sufst/precharge/hardware/precharge/bom-2.ods

Part | MPN | FarnellPartNo | Datasheet | CostExVAT | PrechargeQty | TSALQty | HVSenseQty | MinQty | Total
DC-DC converter | MPWF1212S-3W | 3652712 | https://www.farnell.com/datasheets/3195172.pdf | £4.61 | 1 |  | 1 | 1 | £9.22
Power resistor | HSA50680RJ | 2058970 | https://www.farnell.com/datasheets/1498243.pdf | £4.07 | 1 |  |  | 1 | £4.07
Fuseholder clip | 8040.0001 | 1829517 | https://www.farnell.com/datasheets/2349362.pdf | £0.84 | 1 |  |  | 10 | £8.44
Fuse | 70-125-40/2A | 1175103 | https://www.farnell.com/datasheets/54183.pdf | £3.43 | 1 |  |  | 1 | £3.43
Optocoupler | 140817141410 | 3619675 | https://www.farnell.com/datasheets/3177005.pdf | £0.20 | 3 |  | 2 | 1 | £1.02
Small relays | G5Q-1EU DC12 | 4446434 | https://www.farnell.com/datasheets/2182433.pdf | £1.28 | 2 |  |  | 1 | £2.56
Updated small relay | PCH-112L2MH | 9659331 | https://www.farnell.com/datasheets/1922598.pdf | £1.52 | 2 |  |  | 1 | £3.04
10u | MCGPR50V106M5X11 | 9451382 | https://www.farnell.com/datasheets/2861351.pdf | £0.05 | 1 | 6 |  | 1 | £0.35
3.3u | MCGPR50V335M5X11 | 1902898 | https://www.farnell.com/datasheets/2861351.pdf | £0.05 | 1 |  |  | 1 | £0.05
4.7u | MCGPR50V475M5X11 | 9451374 | https://www.farnell.com/datasheets/2861351.pdf | £0.05 | 1 |  |  | 1 | £0.05
22u | MCGPR25V226M5X11 | 9451161 | https://www.farnell.com/datasheets/2861351.pdf | £0.05 | 1 |  | 1 | 1 | £0.10
100u | MCGPR25V107M6.3X11 | 9451188 | https://www.farnell.com/datasheets/2861351.pdf | £0.09 | 2 | 2 | 1 | 1 | £0.45
100n | MC0603B104K500CT | 1759122 | https://www.farnell.com/datasheets/2860632.pdf | £0.03 | 5 | 7 | 1 | 10 | £0.39
Diode | SS14+ | 2675133 | https://www.farnell.com/datasheets/2861407.pdf | £0.14 | 2 |  |  | 5 | £0.71
Diode | BAT54WFILM | 3214563 | https://www.farnell.com/datasheets/2124315.pdf | £0.22 | 8 | 5 | 1 | 5 | £3.02
Red LED | MP008277 | 3796306 | https://www.farnell.com/datasheets/3497874.pdf | £0.07 | 3 |  |  | 5 | £0.37
Green LED | MC011367 | 3015160 | https://www.farnell.com/datasheets/2864184.pdf | £0.03 | 5 |  | 1 | 5 | £0.16
NPN BJT | BC846A,215 | 1081228 |  | £0.11 | 1 |  |  | 5 | £0.54
PNP BJT | BC856A | 1798064 | https://www.farnell.com/datasheets/2915414.pdf | £0.09 | 3 |  |  | 5 | £0.43
Bigger MOSFETS | BUK7M9R5-40HX | 3020973 |  | £0.27 | 1 | 2 |  | 1 | £0.82
Small MOSFETs | XP262N7002TR-G | 3534793 | https://www.farnell.com/datasheets/3118352.pdf | £0.16 | 2 |  |  | 5 | £0.79
1k 0603 | MCWR06X1001FTL | 2447272 | https://www.farnell.com/datasheets/2860681.pdf | £0.00 | 6 |  |  | 10 | £0.04
1k 1206 | MCWR12X1001FTL | 2447473 |  | £0.01 | 3 |  | 2 | 10 | £0.12
10k | WF06P1002FTL | 2502802 | https://www.farnell.com/datasheets/1960323.pdf | £0.00 | 5 | 10 | 2 | 10 | £0.08
33k | ERA3VRB3302V | 3602666 | https://www.farnell.com/datasheets/3170174.pdf | £0.44 | 3 |  |  | 10 | £4.43
82k | WF06U8202BTL | 2502992 | https://www.farnell.com/datasheets/2341551.pdf | £0.06 | 1 |  |  | 10 | £0.62
1.5k | WF06U1501BTL | 2502942 | https://www.farnell.com/datasheets/2341550.pdf | £0.07 | 5 |  |  | 10 | £0.69
30k | CPF-A-0603B30KE1 | 2483916 | https://www.farnell.com/datasheets/1935020.pdf | £0.33 | 1 |  |  | 1 | £0.33
453k (0805) | MCWF08R4533BTL | 2337864 | https://www.farnell.com/datasheets/2860647.pdf | £0.16 | 24 |  | 6 | 10 | £4.92
560k (0805) | MCWF08R5603BTL | 2337914 | https://www.farnell.com/datasheets/2860647.pdf | £0.15 |  |  |  | 10 | £1.52
100k | WF06U1003BTL | 2502938 | https://www.farnell.com/datasheets/2341550.pdf | £0.07 | 4 | 1 |  | 10 | £0.68
5.1M | MC0063W060315M10 | 2141614 | https://www.farnell.com/datasheets/1788326.pdf | £0.00 | 1 |  |  | 1 | £0.00
470k | MCWR06X4703FTL | 2447373 | https://www.farnell.com/datasheets/2860681.pdf | £0.00 |  |  |  | 10 | £0.04
47k | CRG0603F47K | 3399581 | https://www.farnell.com/datasheets/2790373.pdf | £0.00 | 1 |  |  | 10 | £0.03
3.3k | CRG0603F3K3 | 3399579 | https://www.farnell.com/datasheets/2790373.pdf | £0.00 | 6 |  | 2 | 10 | £0.03
Thermistor | NCU18WF104J60RB | 3471633 | https://www.farnell.com/datasheets/3007002.pdf | £0.08 | 1 |  |  | 10 | £0.77
Op-amp | TLV274DR2G | 3588895 | https://www.onsemi.com/pub/Collateral/TLV271-D.PDF | £1.02 | 1 |  | 1 | 5 | £5.10
Hex Schmitt inverter | HCF40106YM013TR | 2762696 | https://www.farnell.com/datasheets/1790272.pdf | £0.54 | 1 | 3 |  | 5 | £2.70
Comparator | LM339DR2G | 1651910 | https://www.farnell.com/datasheets/2353742.pdf | £0.51 |  |  |  | 5 | £2.55
Flip-flop | CD4013BM96G4 | 3119949 |  | £0.55 | 1 | 1 |  | 1 | £1.10
OR gate | CD4071BM | 3006431 | https://www.farnell.com/datasheets/1878535.pdf | £0.50 | 1 | 1 |  | 1 | £1.00
105k | WF08U1053BTL | 2670115 |  | £0.09 | 1 |  |  | 10 | £0.93
31.6k | MCWF06R3162BTL | 2337131 |  | £0.11 | 1 |  |  | 10 | £1.06
348k | MCTC0525B3483T5G | 1576077 |  | £0.02 | 1 |  |  | 1 | £0.02
82r | MCSR06X82R0FTL | 2074314 |  | £0.01 | 1 |  |  | 10 | £0.09
150k | MCWF08U1503BTL | 2694207 |  | £0.17 | 1 |  |  | 10 | £1.67
Voltage reference | TL431ACDT | 2463970 |  | £0.36 | 1 |  |  | 5 | £1.79
Potentiometer | 3296W-1-504LF | 9353313 | https://www.farnell.com/datasheets/2061261.pdf | £2.19 | 1 |  |  | 1 | £2.19
Bright red LED | 150283RS73103 | 3408631 |  | £0.66 | 2 |  |  |  | £1.33
Bright green LED | 150283GS73103 | 3408634 |  | £0.71 | 2 |  |  |  | £1.41
82r 2512 | CRM2512-JW-820ELF | 2908507 |  | £0.19 | 8 |  |  | 10 | £1.93
27r 2512 | MCHP122WF270JT4E | 2426565 |  | £0.27 | 6 |  |  | 10 | £2.65
AND gate | CD4081BM96 | 3120149 |  | £0.57 | 2 |  |  | 5 | £2.84
 |  |  |  |  |  |  |  |  | £84.64
