sufst/precharge/hardware/precharge/step/pch-112l2mh.stp

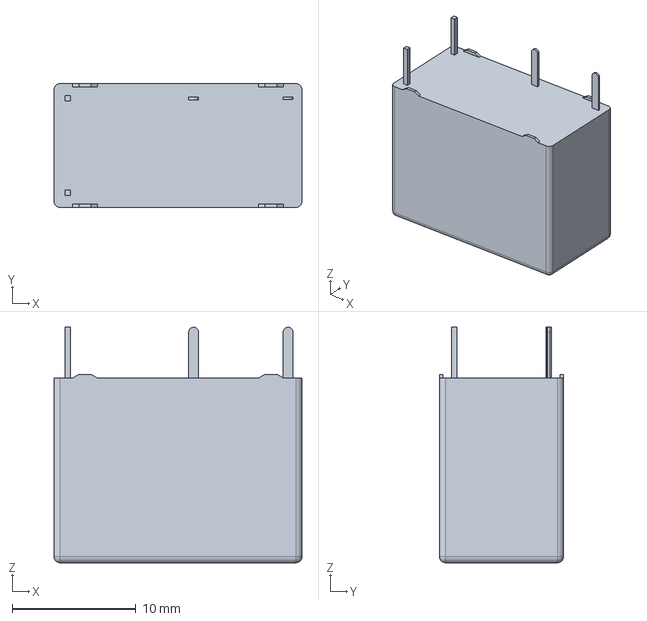
[picture p1: CAD file, 2022-04-21]
hardware/precharge/step/pch-112l2mh.stp
20.0 x 10.0 x 19.0 mm
