sufst/precharge/hardware/precharge/step/conn_molex-5-pin.stp

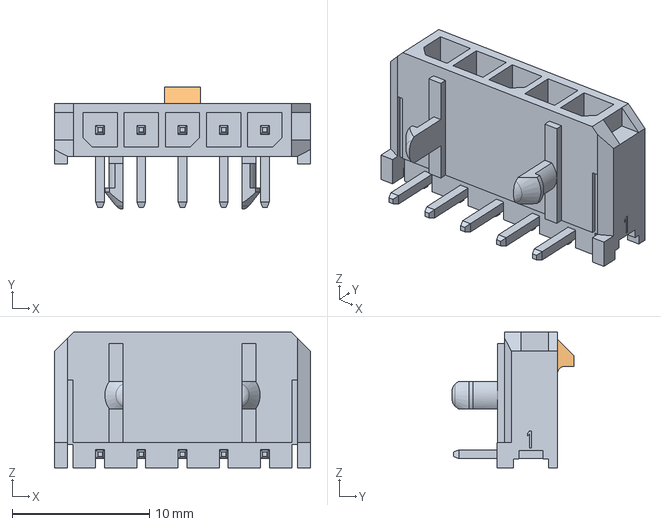
[picture p2: CAD file, 2022-04-21]
hardware/precharge/step/conn_molex-5-pin.stp
18.6 x 8.91 x 9.90 mm
