sufst/precharge/hardware/precharge/step/fuseholder.STEP

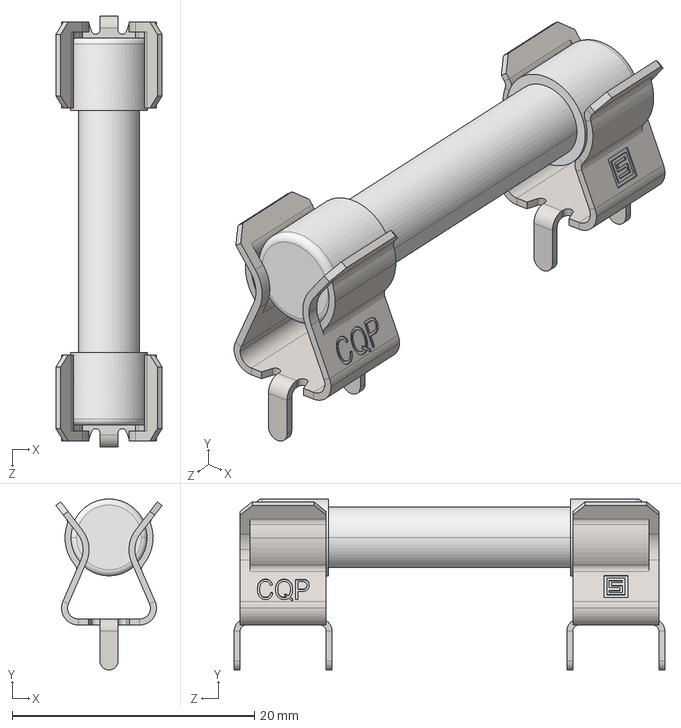
[picture p3: CAD file, 2022-04-21]
hardware/precharge/step/fuseholder.STEP
8.77 x 14.1 x 35.6 mm
