sufst/precharge/hardware/precharge/step/conn_molex-2-pin.stp

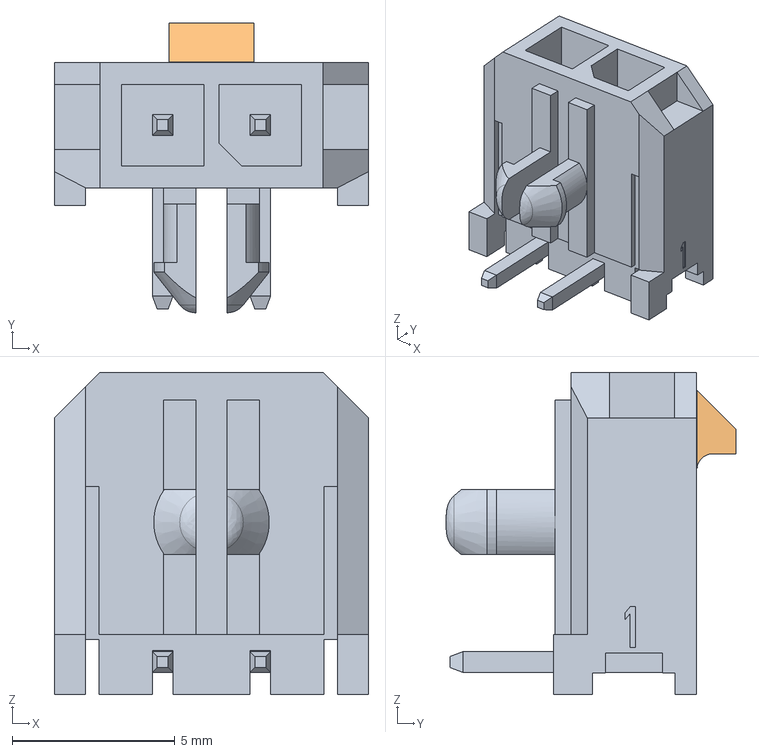
[picture p4: CAD file, 2022-04-21]
hardware/precharge/step/conn_molex-2-pin.stp
9.65 x 8.91 x 9.90 mm
