sufst/precharge/hardware/precharge/step/conn_molex-4-pin.stp

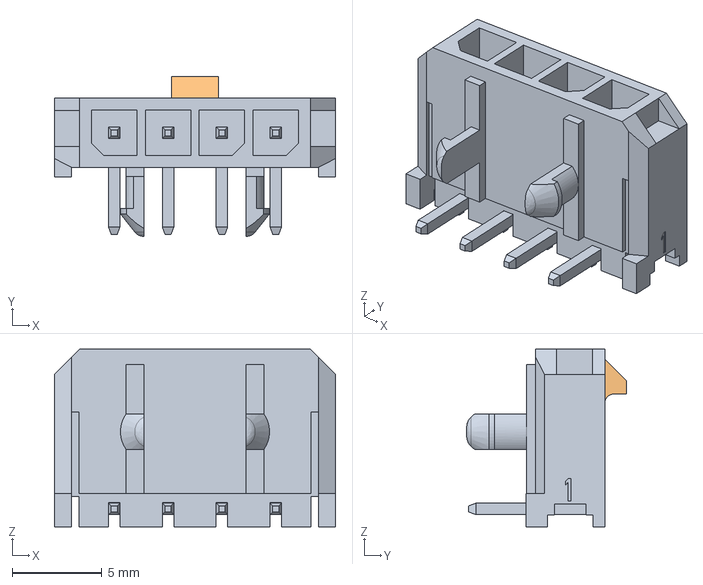
[picture p5: CAD file, 2022-04-21]
hardware/precharge/step/conn_molex-4-pin.stp
15.7 x 8.91 x 9.90 mm
