sufst/precharge/hardware/precharge/step/G5Q_1.step

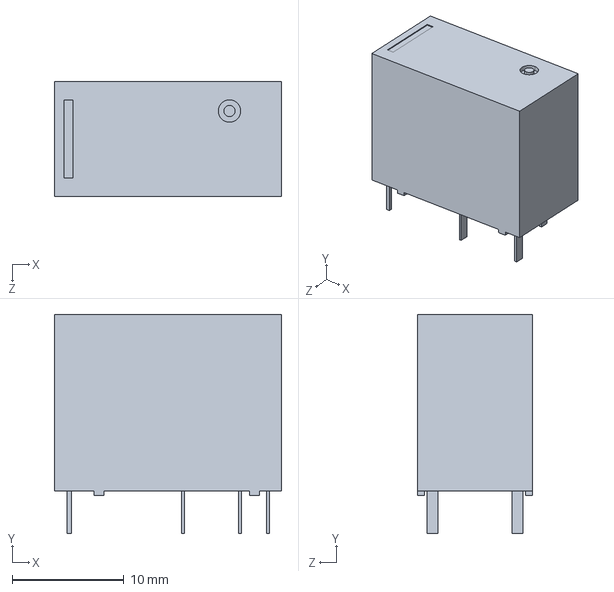
[picture p6: CAD file, 2022-04-21]
hardware/precharge/step/G5Q_1.step
20.3 x 19.6 x 10.3 mm
