sufst/precharge/hardware/precharge/step/conn_molex-3-pin.stp

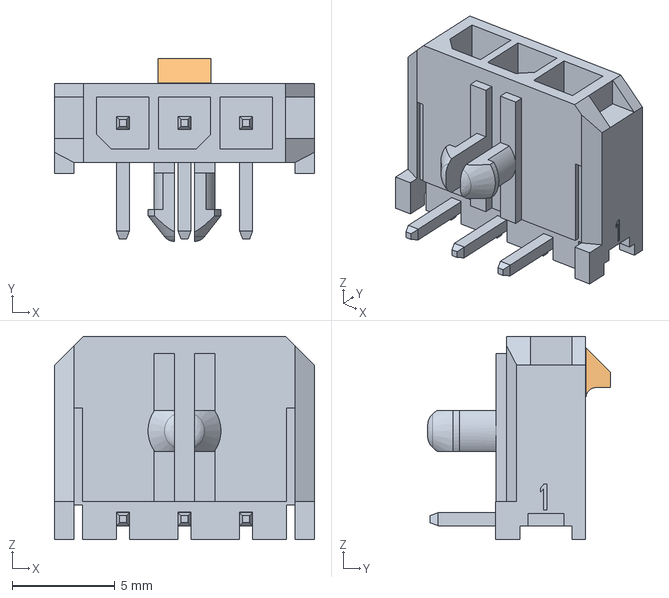
[picture p7: CAD file, 2022-04-21]
hardware/precharge/step/conn_molex-3-pin.stp
12.7 x 8.90 x 9.90 mm
