sufst/precharge/hardware/precharge/step/conn_molex-6-pin.stp

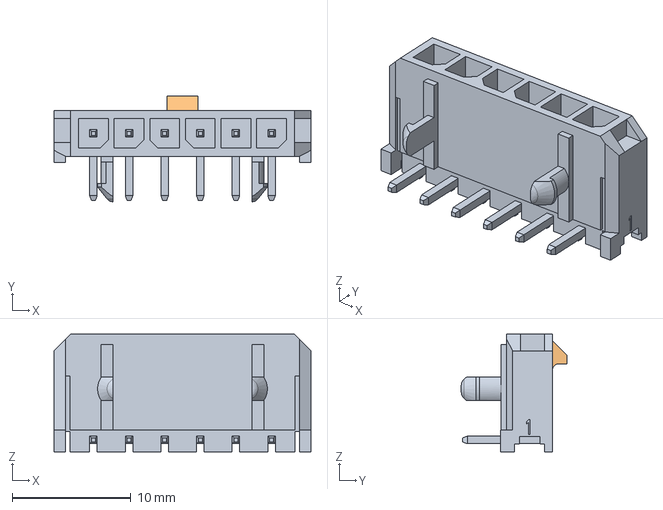
[picture p8: CAD file, 2022-04-21]
hardware/precharge/step/conn_molex-6-pin.stp
21.6 x 8.90 x 9.90 mm
