sufst/precharge/simulations/LTSpice/measurement.asc

C1: cap; 10µ
C2: cap; 3.3µ
C3: cap; 280µ
D1: diode
D2: diode
Q1: pnp
Q2: pnp
Q3: pnp
R1: res; 2820k
R2: res; 2820k
R3: res; 33k
R4: res; 33k
R5: res; 680
R6: res; 2820k
R7: res; 33k
R8: res; 31.8k
R9: res; 82k
R10: res; 2740k
R11: res; 100k
R12: res; 100k
R13: res; 5.1e6
R14: res; 30k
U1: UniversalOpamp2
V1: voltage; PULSE(0 600 0.1 0.1 0.0001 10 100)
V2: voltage; 12
V3: voltage; SINE(0 1 500)
V4: voltage; SINE(0 1 600)
Named nets: 0, +600V, +12V, SLOW, FAST, NORMAL, ACC_SAMPLE, TS_SAMPLE, N_CHARGED
RC = 0.33
RC = 0.11
.tran 0 2 0 0.0001
RC = 0.19
Noise simulation to test hysteresis
