sufst/precharge/simulations/LTSpice/precharge.asc

Accumulator: voltage; PULSE(0 579.6V 1 0.01 0.01 10)
C_inv: cap; 280µF
R_acc: res; 0
R_inv: res; 188k
R_precharge: res; 1k
Named nets: 0, acc, inv
todo: 
add estimated series resistance to accumulator
add internal resistance of inverter
.tran 10s
