sufst/precharge/hardware/precharge/precharge.kicad_pcb

## KiCad design hardware/precharge/precharge.kicad_pcb (2022-10-03)

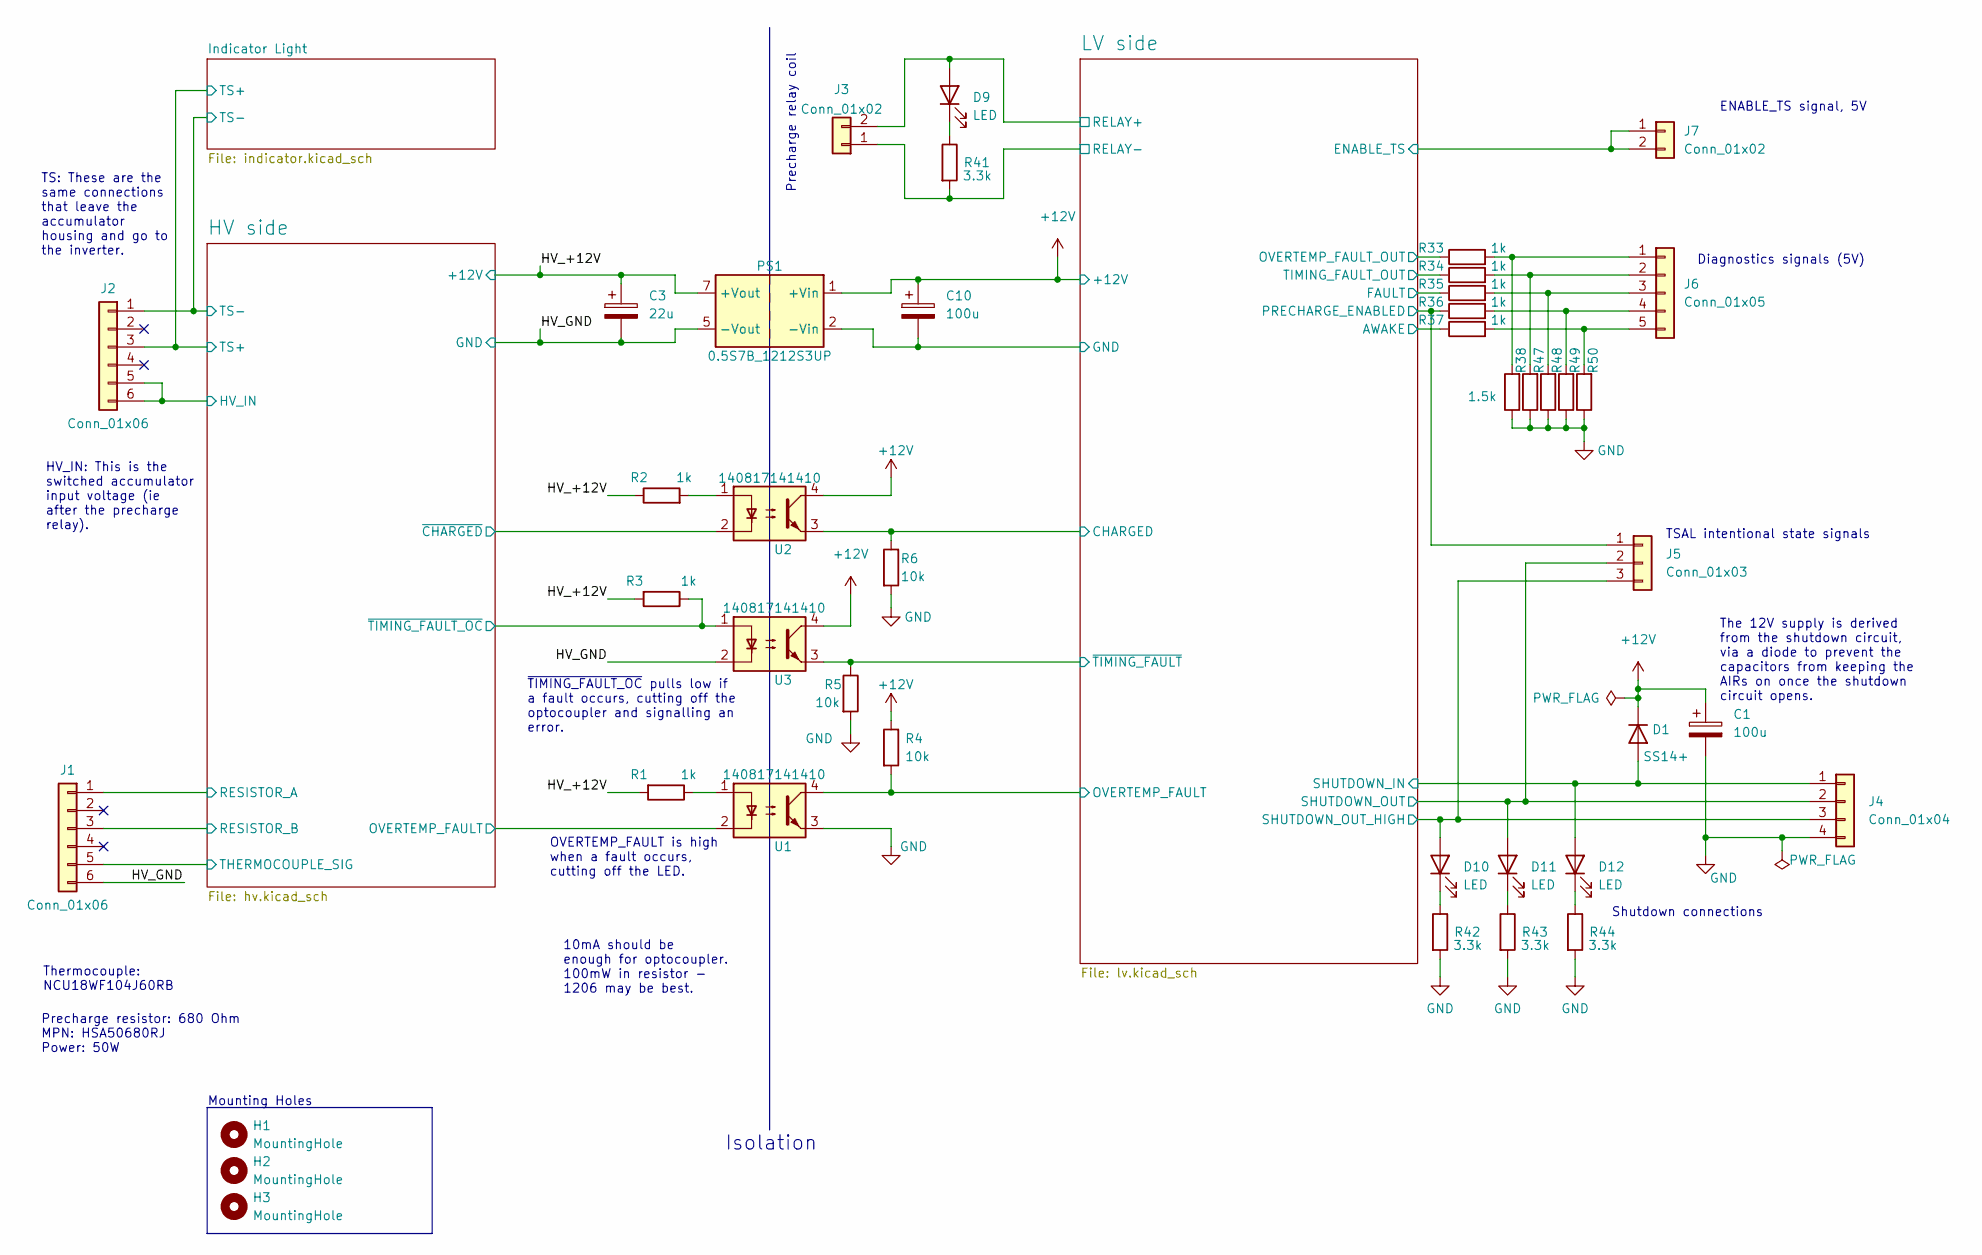
[picture p9: schematic precharge.kicad_sch, Precharge Top Level]

Parts:
C1, C10: 100u; CP_Radial_D6.3mm_P2.50mm
C3: 22u; CP_Radial_D8.0mm_P3.50mm
D1: SS14+; D_SMA
D9, D10, D11, D12: LED; LED_0603_1608Metric
H1, H2, H3: MountingHole; MountingHole_3.2mm_M3
J1, J2: Conn_01x06; Molex_Micro-Fit_3.0_43650-0600_1x06_P3.00mm_Horizontal
J3, J7: Conn_01x02; Molex_Micro-Fit_3.0_43650-0200_1x02_P3.00mm_Horizontal
J4: Conn_01x04; Molex_Micro-Fit_3.0_43650-0400_1x04_P3.00mm_Horizontal
J5: Conn_01x03; Molex_Micro-Fit_3.0_43650-0300_1x03_P3.00mm_Horizontal
J6: Conn_01x05; Molex_Micro-Fit_3.0_43650-0500_1x05_P3.00mm_Horizontal
PS1: 0.5S7B_1212S3UP
R1, R2, R3: 1k; R_1206_3216Metric
R4, R5, R6: 10k; R_0603_1608Metric
R33, R34, R35, R36, R37: 1k; R_0603_1608Metric
R38, R47, R48, R49, R50: 1.5k; R_0603_1608Metric
R41, R42, R43, R44: 3.3k; R_0603_1608Metric
U1, U2, U3: 140817141410; DIP-4_W10.16mm

Connections:
+12V: C1.1, C10.1, D1.1 (K), PS1.1 (+Vin), R4.1, U2.4, U3.4; also elsewhere on the board
/HV side/HV_IN: J2.5, J2.6; also elsewhere on the board
/HV side/OVERTEMP_FAULT: U1.2; also elsewhere on the board
/HV side/RESISTOR_A: J1.1; also elsewhere on the board
/HV side/RESISTOR_B: J1.3, J2.3; also elsewhere on the board
/HV side/THERMOCOUPLE_SIG: J1.5; also elsewhere on the board
/HV side/TS-: J2.1; also elsewhere on the board
/HV side/~CHARGED: U2.2; also elsewhere on the board
/HV side/~TIMING_FAULT_OC: R3.1, U3.1; also elsewhere on the board
/HV_+12V: C3.1, PS1.7 (+Vout), R1.2, R2.1, R3.2; also elsewhere on the board
/HV_GND: C3.2, J1.6, PS1.5 (-Vout), U3.2; also elsewhere on the board
/LV side/AWAKE: R37.1; also elsewhere on the board
/LV side/CHARGED: R6.1, U2.3; also elsewhere on the board
/LV side/ENABLE_TS: J7.1, J7.2; also elsewhere on the board
/LV side/FAULT: R35.1; also elsewhere on the board
/LV side/GND: C10.2, PS1.2 (-Vin); also elsewhere on the board
/LV side/OVERTEMP_FAULT: R4.2, U1.4; also elsewhere on the board
/LV side/OVERTEMP_FAULT_OUT: R33.1; also elsewhere on the board
/LV side/PRECHARGE_ENABLED: J5.1, R36.1; also elsewhere on the board
/LV side/RELAY+: D9.2 (A), J3.2; also elsewhere on the board
/LV side/RELAY-: J3.1, R41.2; also elsewhere on the board
/LV side/SHUTDOWN_IN: D1.2 (A), D12.2 (A), J4.1; also elsewhere on the board
/LV side/SHUTDOWN_OUT: D11.2 (A), J4.2, J5.2; also elsewhere on the board
/LV side/SHUTDOWN_OUT_HIGH: D10.2 (A), J4.3, J5.3; also elsewhere on the board
/LV side/TIMING_FAULT_OUT: R34.1; also elsewhere on the board
/LV side/~TIMING_FAULT: R5.1, U3.3; also elsewhere on the board
GND: C1.2, J4.4, R5.2, R6.2, R38.1, R42.2, R43.2, R44.2, R47.1, R48.1, R49.1, R50.1, U1.3
unnamed: D9.1 (K), R41.1
unnamed: D10.1 (K), R42.1
unnamed: D11.1 (K), R43.1
unnamed: D12.1 (K), R44.1
unnamed: J6.1, R33.2, R38.2
unnamed: J6.2, R34.2, R47.2
unnamed: J6.3, R35.2, R48.2
unnamed: J6.4, R36.2, R49.2
unnamed: J6.5, R37.2, R50.2
unnamed: R1.1, U1.1
unnamed: R2.2, U2.1

Notes on the sheet:
10mA should be enough for optocoupler. 100mW in resistor - 1206 may be best.
Diagnostics signals (5V)
OVERTEMP_FAULT is high when a fault occurs, cutting off the LED.
Isolation
~{TIMING_FAULT_OC} pulls low if a fault occurs, cutting off the optocoupler and signalling an error.
Precharge relay coil
ENABLE_TS signal, 5V
Shutdown connections
Thermocouple: NCU18WF104J60RB
Mounting Holes
TS: These are the same connections that leave the accumulator housing and go to the inverter.
HV_IN: This is the switched accumulator input voltage (ie after the precharge relay).
Precharge resistor: 680 Ohm MPN: HSA50680RJ Power: 50W
TSAL intentional state signals
The 12V supply is derived from the shutdown circuit, via a diode to prevent the capacitors from keeping the AIRs on once the shutdown circuit opens.

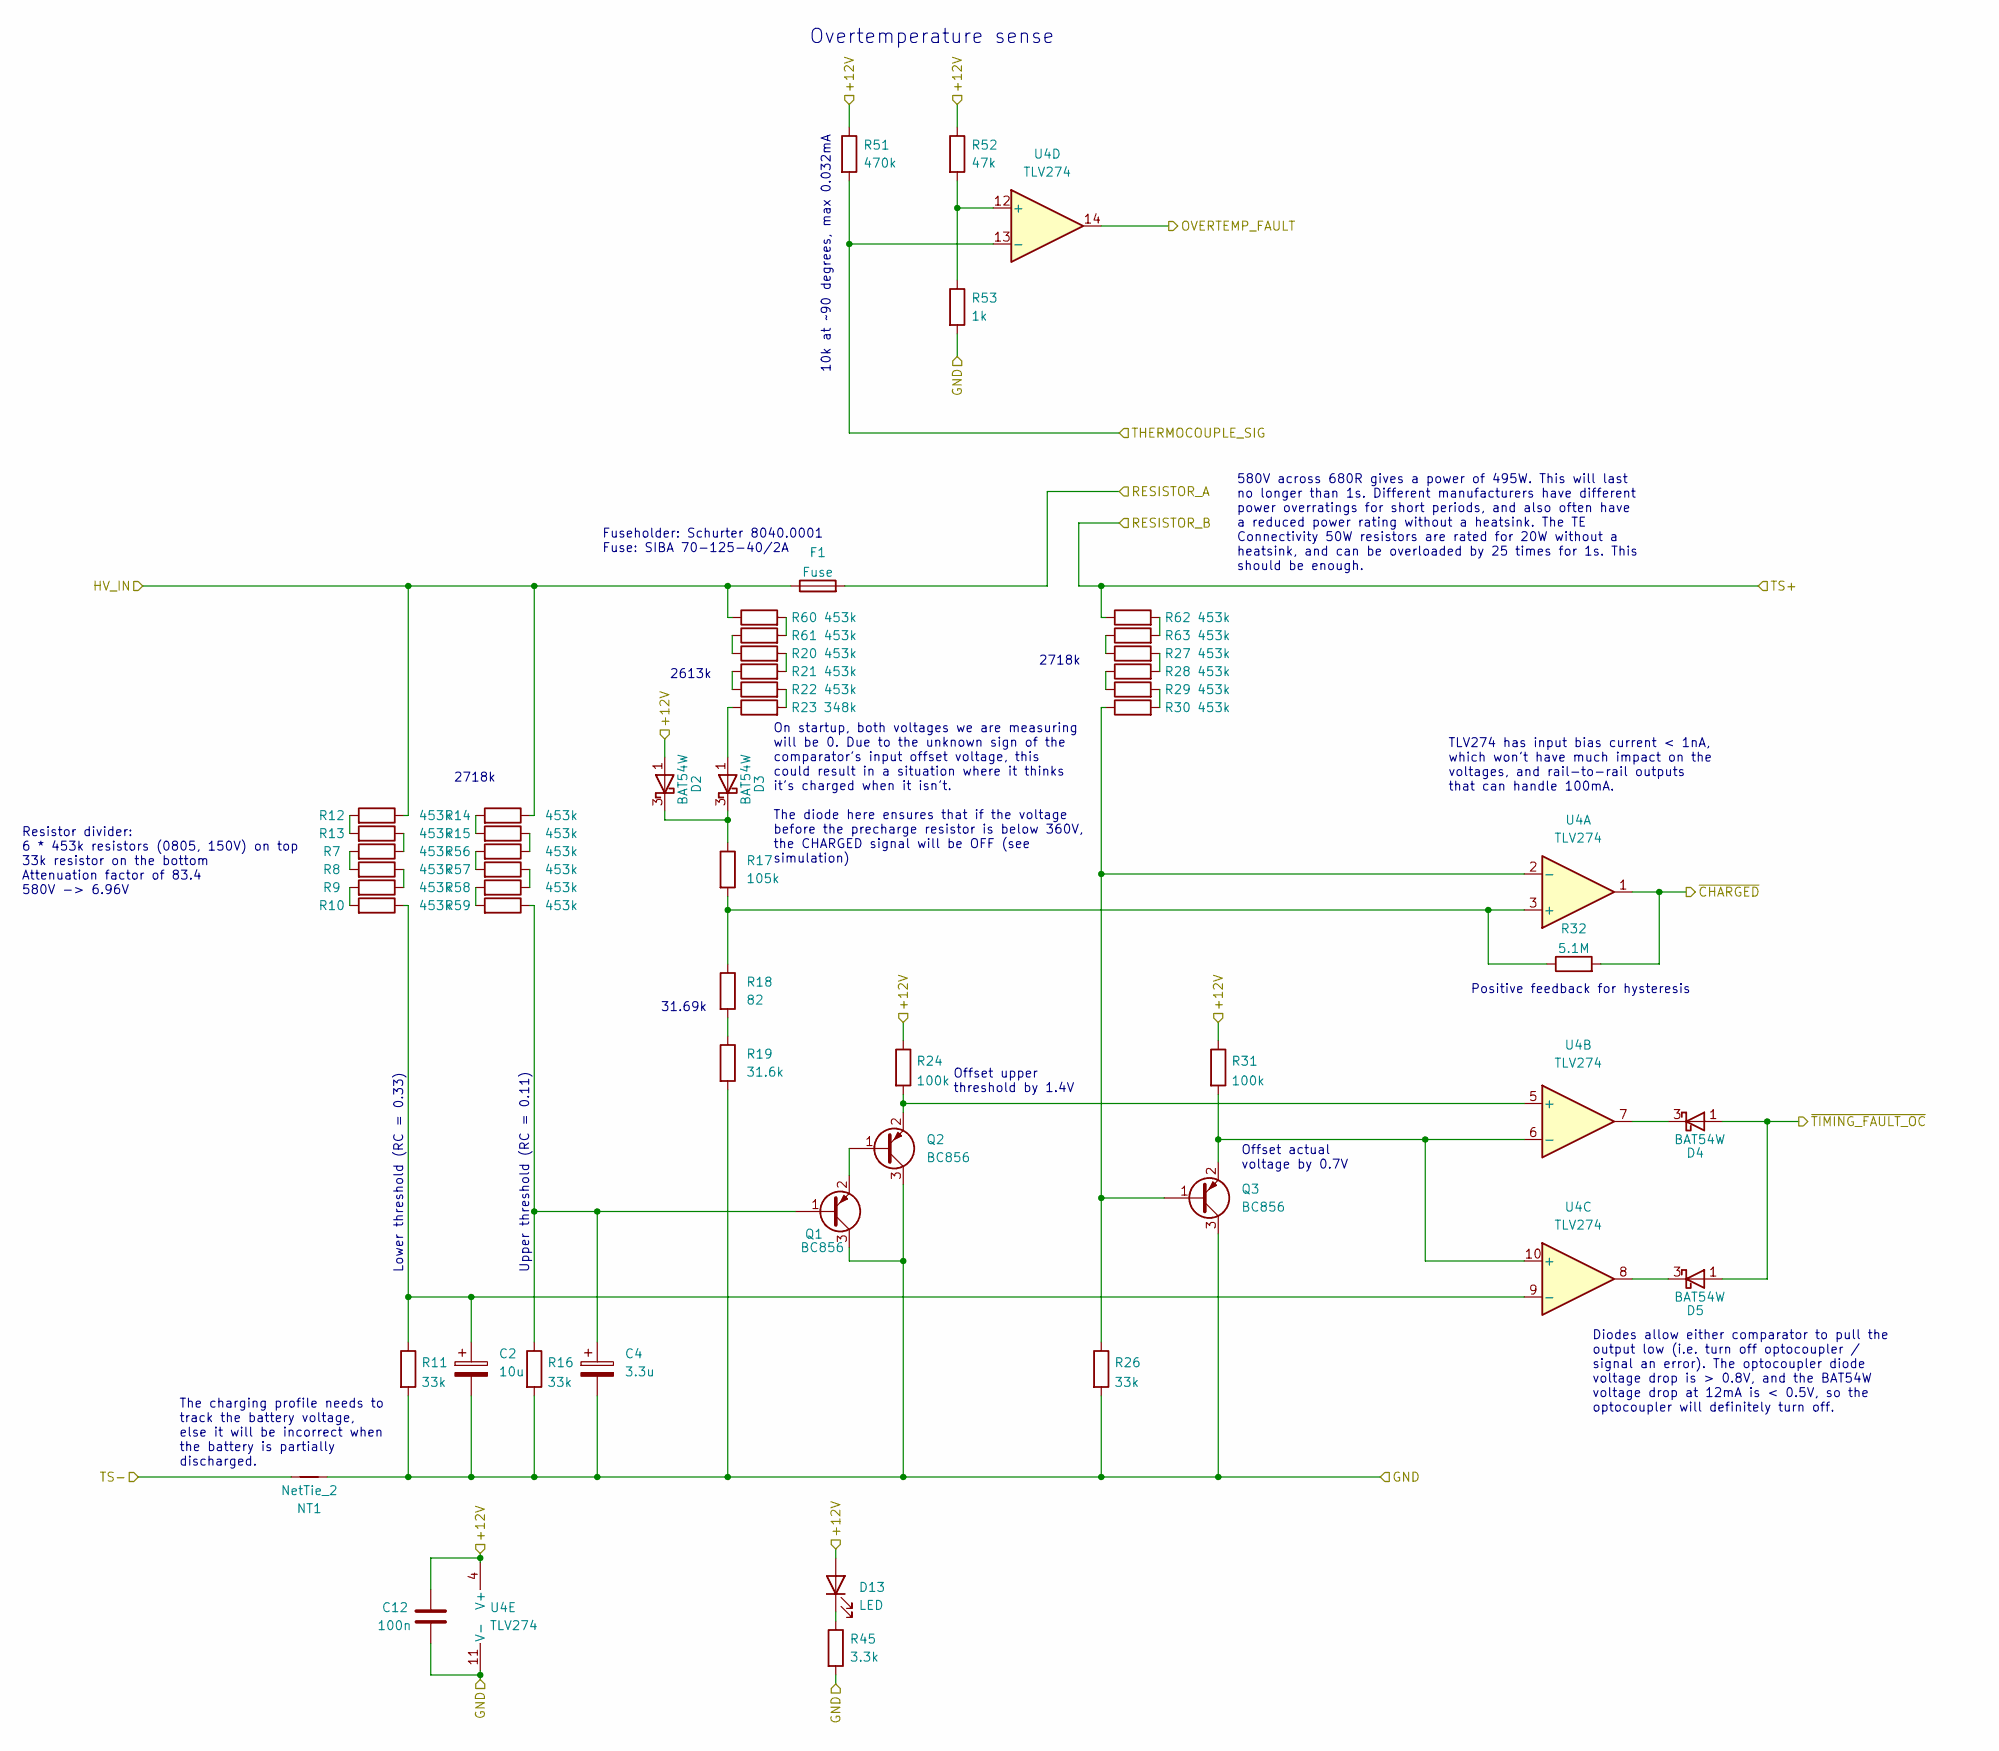
[picture p10: schematic hv.kicad_sch, Precharge HV Side]

Parts:
C2: 10u; CP_Radial_D5.0mm_P2.00mm
C4: 3.3u; CP_Radial_D5.0mm_P2.00mm
C12: 100n; C_0603_1608Metric
D2, D3, D4, D5: BAT54W; SOT-323_SC-70
D13: LED; LED_0603_1608Metric
F1: Fuse; fuseholder
NT1: NetTie_2; NetTie-2_SMD_Pad0.5mm
Q1, Q2, Q3: BC856; SOT-23
R7, R8, R9, R10, R12, R13, R14, R15, R20, R21, R22, R27, R28, R29, R30, R56, R57, R58, R59, R60, R61, R62, R63: 453k; R_0805_2012Metric
R11, R16, R26: 33k; R_0603_1608Metric
R17: 105k; R_0805_2012Metric
R18: 82; R_0603_1608Metric
R19: 31.6k; R_0603_1608Metric
R23: 348k; R_0805_2012Metric
R24, R31: 100k; R_0603_1608Metric
R32: 5.1M; R_0603_1608Metric
R45: 3.3k; R_0603_1608Metric
R51: 470k; R_0603_1608Metric
R52: 47k; R_0603_1608Metric
R53: 1k; R_0603_1608Metric
U4: TLV274; SOIC-14_3.9x8.7mm_P1.27mm

Connections:
/HV side/HV_IN: F1.1, R12.1, R14.1, R60.1; also elsewhere on the board
/HV side/OVERTEMP_FAULT: U4.14; also elsewhere on the board
/HV side/RESISTOR_A: F1.2; also elsewhere on the board
/HV side/RESISTOR_B: R62.1; also elsewhere on the board
/HV side/THERMOCOUPLE_SIG: R51.2, U4.13 (-); also elsewhere on the board
/HV side/TS-: NT1.2; also elsewhere on the board
/HV side/~CHARGED: R32.2, U4.1; also elsewhere on the board
/HV side/~TIMING_FAULT_OC: D4.1 (A), D5.1 (A); also elsewhere on the board
/HV_+12V: C12.1, D2.1 (A), D13.2 (A), R24.1, R31.1, R51.1, R52.1, U4.4 (V+); also elsewhere on the board
/HV_GND: C2.2, C4.2, C12.2, NT1.1, Q1.3 (C), Q2.3 (C), Q3.3 (C), R11.2, R16.2, R19.2, R26.2, R45.2, R53.2, U4.11 (V-); also elsewhere on the board
unnamed: C2.1, R10.1, R11.1, U4.9 (-)
unnamed: C4.1, Q1.1 (B), R16.1, R59.1
unnamed: D2.3 (K), D3.3 (K), R17.1
unnamed: D3.1 (A), R23.1
unnamed: D4.3 (K), U4.7
unnamed: D5.3 (K), U4.8
unnamed: D13.1 (K), R45.1
unnamed: Q1.2 (E), Q2.1 (B)
unnamed: Q2.2 (E), R24.2, U4.5 (+)
unnamed: Q3.1 (B), R26.1, R30.1, U4.2 (-)
unnamed: Q3.2 (E), R31.2, U4.6 (-), U4.10 (+)
unnamed: R7.2, R8.2
unnamed: R8.1, R9.1
unnamed: R9.2, R10.2
unnamed: R12.2, R13.2
unnamed: R7.1, R13.1
unnamed: R14.2, R15.2
unnamed: R15.1, R56.1
unnamed: R17.2, R18.1, R32.1, U4.3 (+)
unnamed: R18.2, R19.1
unnamed: R20.1, R61.1
unnamed: R20.2, R21.2
unnamed: R21.1, R22.1
unnamed: R22.2, R23.2
unnamed: R27.1, R63.1
unnamed: R27.2, R28.2
unnamed: R28.1, R29.1
unnamed: R29.2, R30.2
unnamed: R52.2, R53.1, U4.12 (+)
unnamed: R56.2, R57.2
unnamed: R57.1, R58.1
unnamed: R58.2, R59.2
unnamed: R60.2, R61.2
unnamed: R62.2, R63.2

Notes on the sheet:
Resistor divider: 6 * 453k resistors (0805, 150V) on top 33k resistor on the bottom Attenuation factor of 83.4 580V -> 6.96V
On startup, both voltages we are measuring will be 0. Due to the unknown sign of the comparator's input offset voltage, this could result in a situation where it thinks it's charged when it isn't. The diode here ensures that if the voltage before the precharge resistor is below 360V, the CHARGED si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
Diodes allow either comparator to pull the output low (i.e. turn off optocoupler / signal an error). The optocoupler diode voltage drop is > 0.8V, and the BAT54W voltage drop at 12mA is < 0.5V, so the optocoupler will definitely turn off.
Overtemperature sense
TLV274 has input bias current < 1nA, which won't have much impact on the voltages, and rail-to-rail outputs that can handle 100mA.
31.69k
Offset actual voltage by 0.7V
2718k
Fuseholder: Schurter 8040.0001 Fuse: SIBA 70-125-40/2A
Upper threshold (RC = 0.11)
Lower threshold (RC = 0.33)
Offset upper threshold by 1.4V
The charging profile needs to track the battery voltage, else it will be incorrect when the battery is partially discharged.
580V across 680R gives a power of 495W. This will last no longer than 1s. Different manufacturers have different power overratings for short periods, and also often have a reduced power rating without a heatsink. The TE Connectivity 50W resistors are rated for 20W without a heatsink, and can be ove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
2613k
10k at ~90 degrees, max 0.032mA
Positive feedback for hysteresis

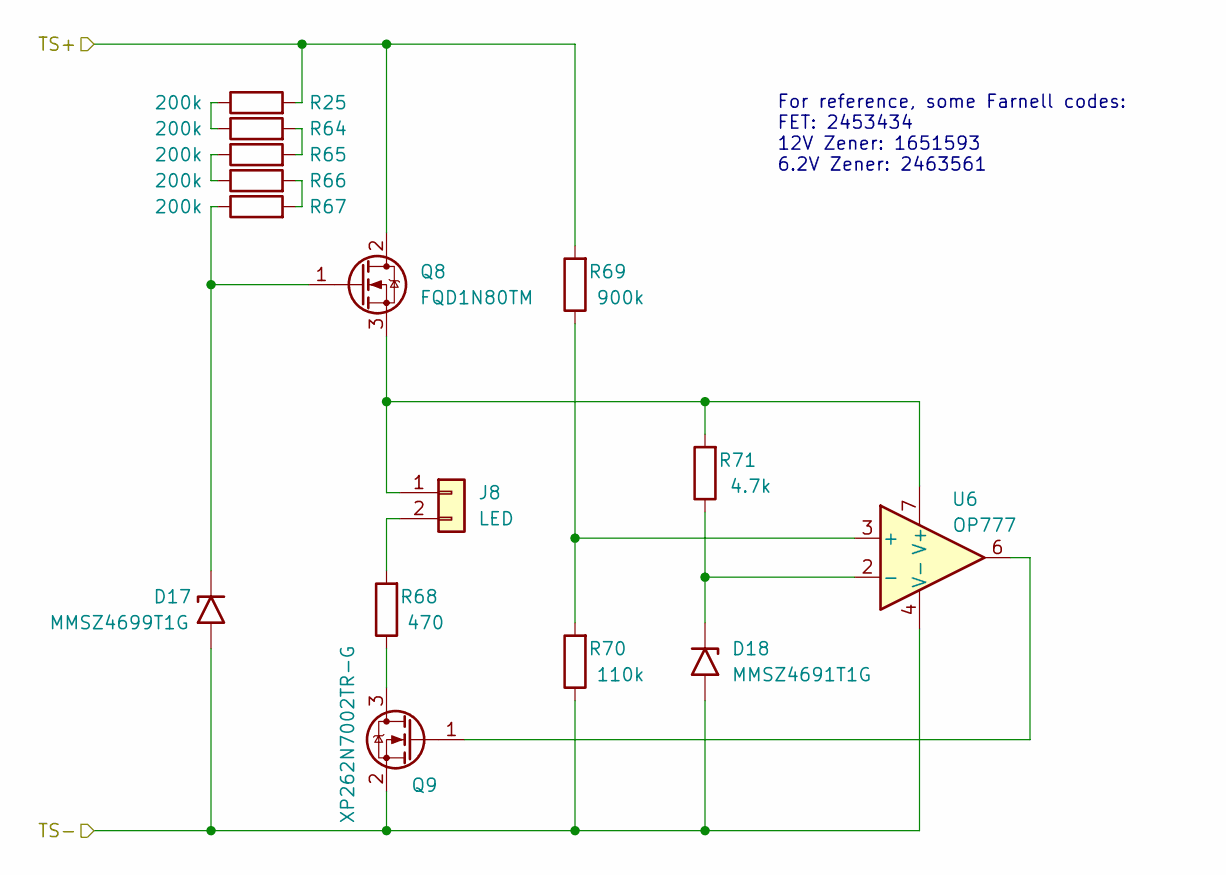
[picture p11: schematic indicator.kicad_sch]

Parts:
D17: MMSZ4699T1G; D_SOD-123
D18: MMSZ4691T1G; D_SOD-123
J8: LED; Molex_Micro-Fit_3.0_43650-0200_1x02_P3.00mm_Horizontal
Q8: FQD1N80TM; TO-252-2
Q9: XP262N7002TR-G; SOT-23
R25, R64, R65, R66, R67: 200k; R_0805_2012Metric
R68: 470; R_0603_1608Metric
R69: 900k; R_0603_1608Metric
R70: 110k; R_0603_1608Metric
R71: 4.7k; R_0603_1608Metric
U6: OP777; SOIC-8_3.9x4.9mm_P1.27mm

Connections:
/HV side/RESISTOR_B: Q8.2 (D), R25.2, R69.2; also elsewhere on the board
/HV side/TS-: D17.2 (A2), D18.2 (A2), Q9.2 (S), R70.1, U6.4 (V-); also elsewhere on the board
unnamed: D17.1 (A1), Q8.1 (G), R67.1
unnamed: D18.1 (A1), R71.1, U6.2 (-)
unnamed: J8.1, Q8.3 (S), R71.2, U6.7 (V+)
unnamed: J8.2, R68.2
unnamed: Q9.1 (G), U6.6
unnamed: Q9.3 (D), R68.1
unnamed: R25.1, R64.1
unnamed: R64.2, R65.2
unnamed: R65.1, R66.1
unnamed: R66.2, R67.2
unnamed: R69.1, R70.2, U6.3 (+)

Notes on the sheet:
For reference, some Farnell codes: FET: 2453434 12V Zener: 1651593 6.2V Zener: 2463561

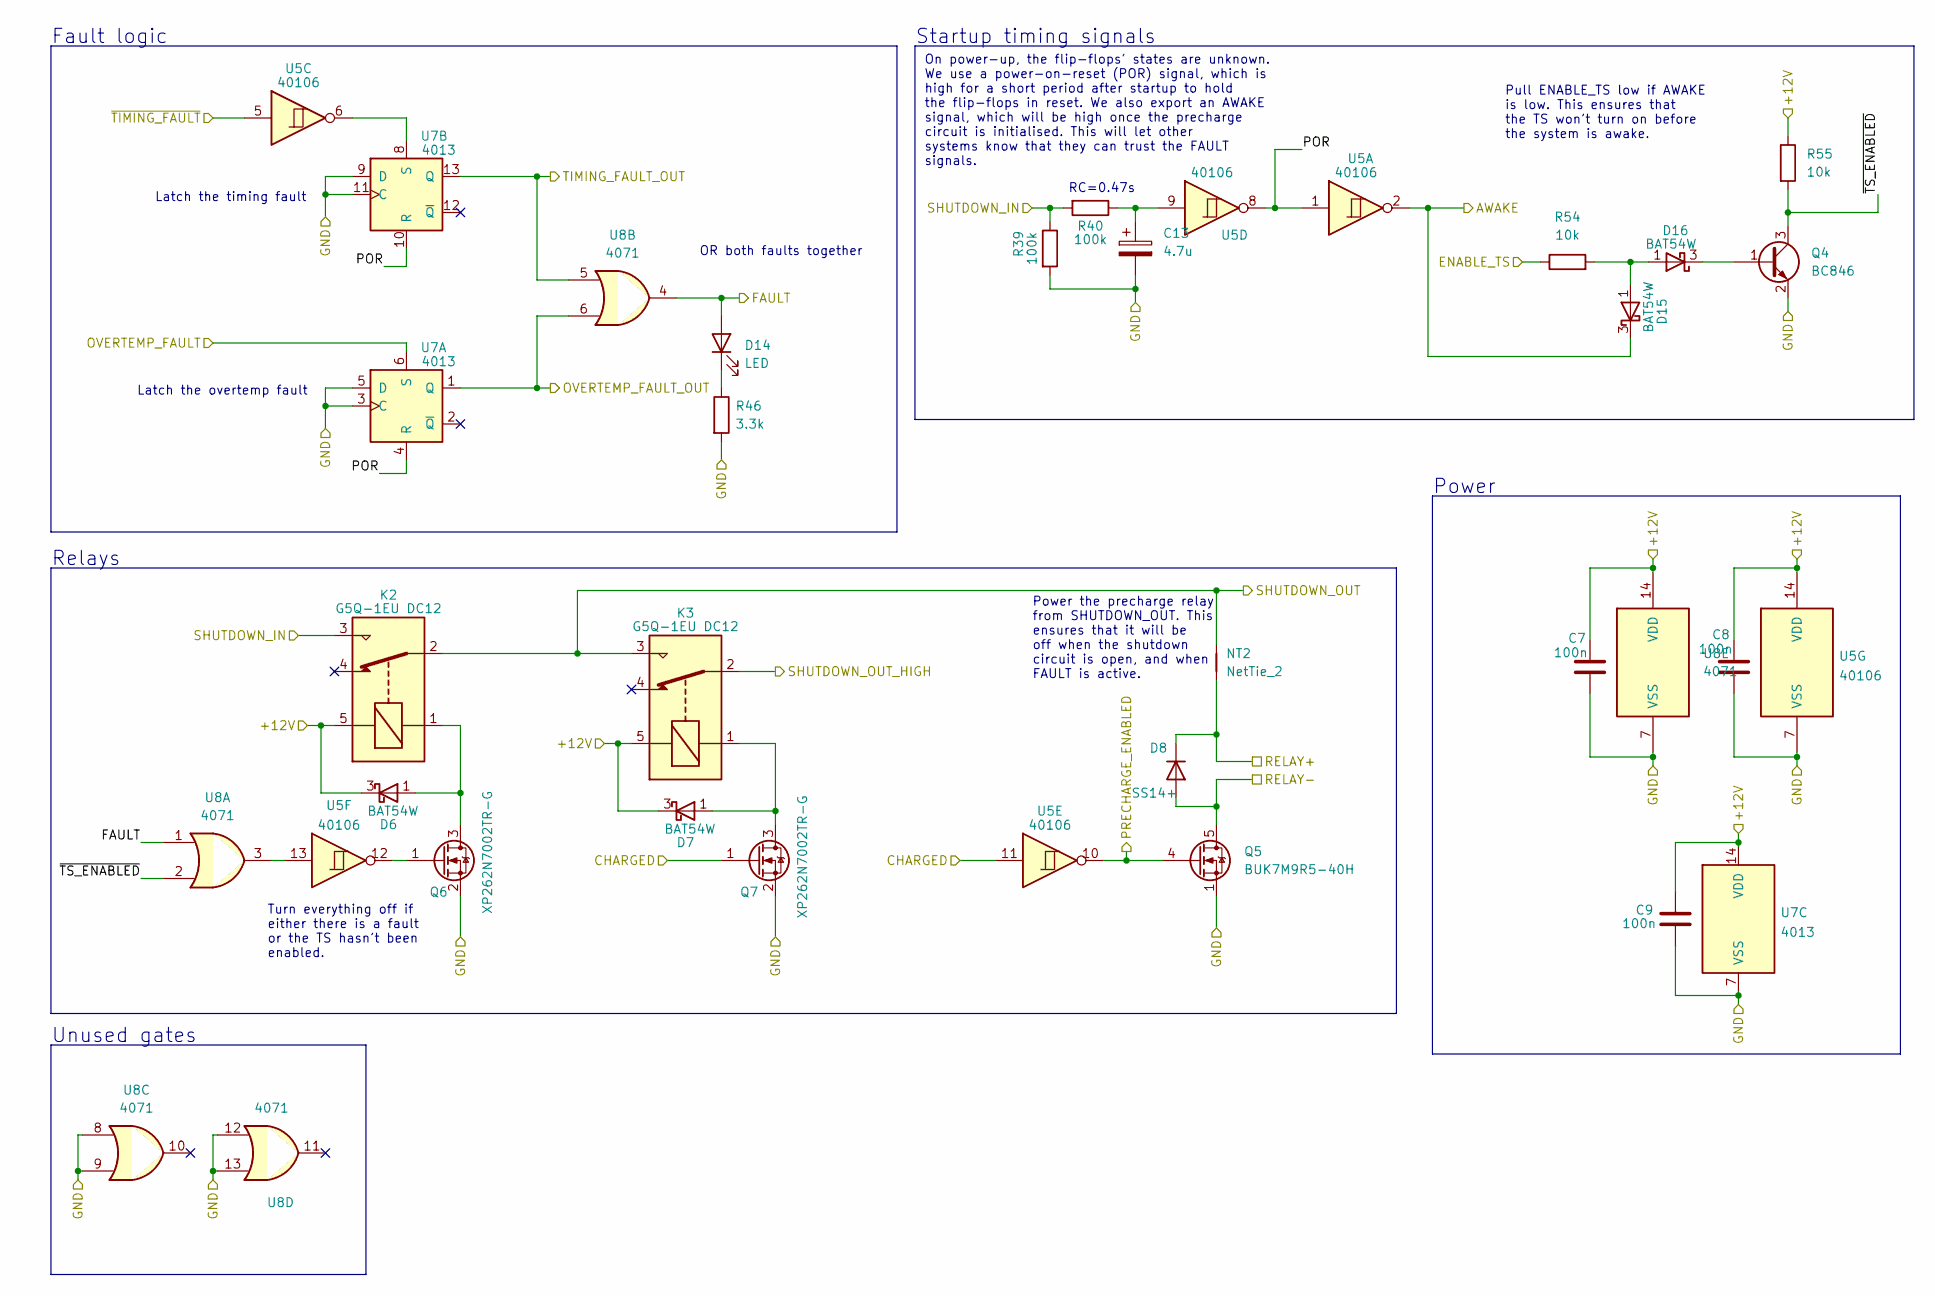
[picture p12: schematic lv.kicad_sch, Precharge LV Side]

Parts:
C7, C8, C9: 100n; C_0603_1608Metric
C13: 4.7u; CP_Radial_D5.0mm_P2.00mm
D6, D7, D15, D16: BAT54W; SOT-323_SC-70
D8: SS14+; D_SMA
D14: LED; LED_0603_1608Metric
K2, K3: G5Q-1EU DC12; PCH-112L2MH
NT2: NetTie_2; NetTie-2_SMD_Pad0.5mm
Q4: BC846; SOT-23
Q5: BUK7M9R5-40H; LFPAK33
Q6, Q7: XP262N7002TR-G; SOT-23
R39, R40: 100k; R_0603_1608Metric
R46: 3.3k; R_0603_1608Metric
R54, R55: 10k; R_0603_1608Metric
U5: 40106; SOIC-14_3.9x8.7mm_P1.27mm
U7: 4013; SOIC-14_3.9x8.7mm_P1.27mm
U8: 4071; SOIC-14_3.9x8.7mm_P1.27mm

Connections:
+12V: C7.1, C8.1, C9.1, D6.3 (K), D7.3 (K), K2.5, K3.5, R55.1, U5.14 (VDD), U7.14 (VDD), U8.14 (VDD); also elsewhere on the board
/LV side/AWAKE: D15.3 (K), U5.2; also elsewhere on the board
/LV side/CHARGED: Q7.1 (G), U5.11; also elsewhere on the board
/LV side/ENABLE_TS: R54.1; also elsewhere on the board
/LV side/FAULT: D14.2 (A), U8.1, U8.4; also elsewhere on the board
/LV side/GND: C7.2, C8.2, C9.2, C13.2, Q4.2 (E), Q5.1 (S), Q5.2 (S), Q5.3 (S), Q6.2 (S), Q7.2 (S), R39.2, R46.2, U5.7 (VSS), U7.3 (C), U7.5 (D), U7.7 (VSS), U7.9 (D), U7.11 (C), U8.7 (VSS), U8.8, U8.9, U8.12, U8.13; also elsewhere on the board
/LV side/OVERTEMP_FAULT: U7.6 (S); also elsewhere on the board
/LV side/OVERTEMP_FAULT_OUT: U7.1 (Q), U8.6; also elsewhere on the board
/LV side/POR: U5.1, U5.8, U7.4 (R), U7.10 (R)
/LV side/PRECHARGE_ENABLED: Q5.4 (G), U5.10; also elsewhere on the board
/LV side/RELAY+: D8.1 (K), NT2.1; also elsewhere on the board
/LV side/RELAY-: D8.2 (A), Q5.5 (D); also elsewhere on the board
/LV side/SHUTDOWN_IN: K2.3, R39.1, R40.2; also elsewhere on the board
/LV side/SHUTDOWN_OUT: K2.2, K3.3, NT2.2; also elsewhere on the board
/LV side/SHUTDOWN_OUT_HIGH: K3.2; also elsewhere on the board
/LV side/TIMING_FAULT_OUT: U7.13 (Q), U8.5; also elsewhere on the board
/LV side/~TIMING_FAULT: U5.5; also elsewhere on the board
/LV side/~TS_ENABLED: Q4.3 (C), R55.2, U8.2
unnamed: C13.1, R40.1, U5.9
unnamed: D6.1 (A), K2.1, Q6.3 (D)
unnamed: D7.1 (A), K3.1, Q7.3 (D)
unnamed: D14.1 (K), R46.1
unnamed: D15.1 (A), D16.1 (A), R54.2
unnamed: D16.3 (K), Q4.1 (B)
unnamed: Q6.1 (G), U5.12
unnamed: U5.6, U7.8 (S)
unnamed: U5.13, U8.3

Notes on the sheet:
Latch the timing fault
Startup timing signals
Latch the overtemp fault
Power
On power-up, the flip-flops' states are unknown. We use a power-on-reset (POR) signal, which is high for a short period after startup to hold the flip-flops in reset. We also export an AWAKE signal, which will be high once the precharge circuit is initialised. This will let other systems know that 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
Power the precharge relay from SHUTDOWN_OUT. This ensures that it will be off when the shutdown circuit is open, and when FAULT is active.
Turn everything off if either there is a fault or the TS hasn't been enabled.
Fault logic
Pull ENABLE_TS low if AWAKE is low. This ensures that the TS won't turn on before the system is awake.
OR both faults together
RC=0.47s
Unused gates
Relays

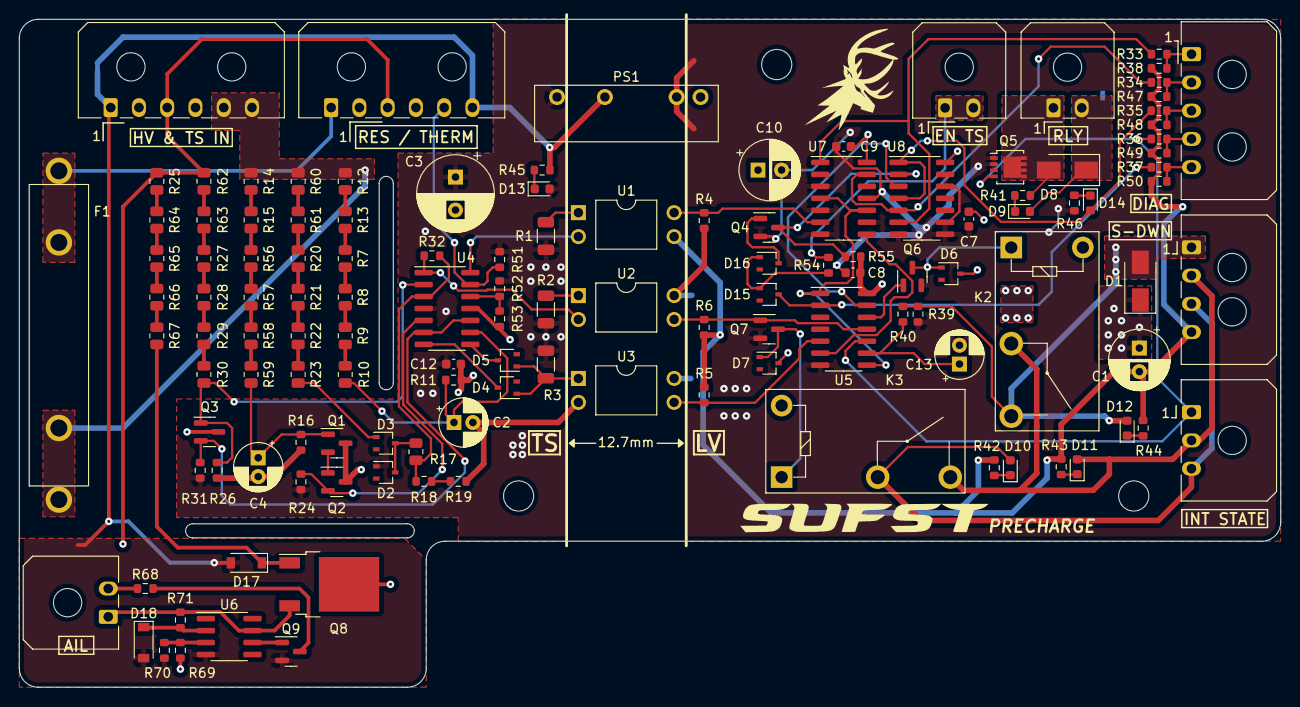
[picture p13: board precharge.kicad_pcb from above]

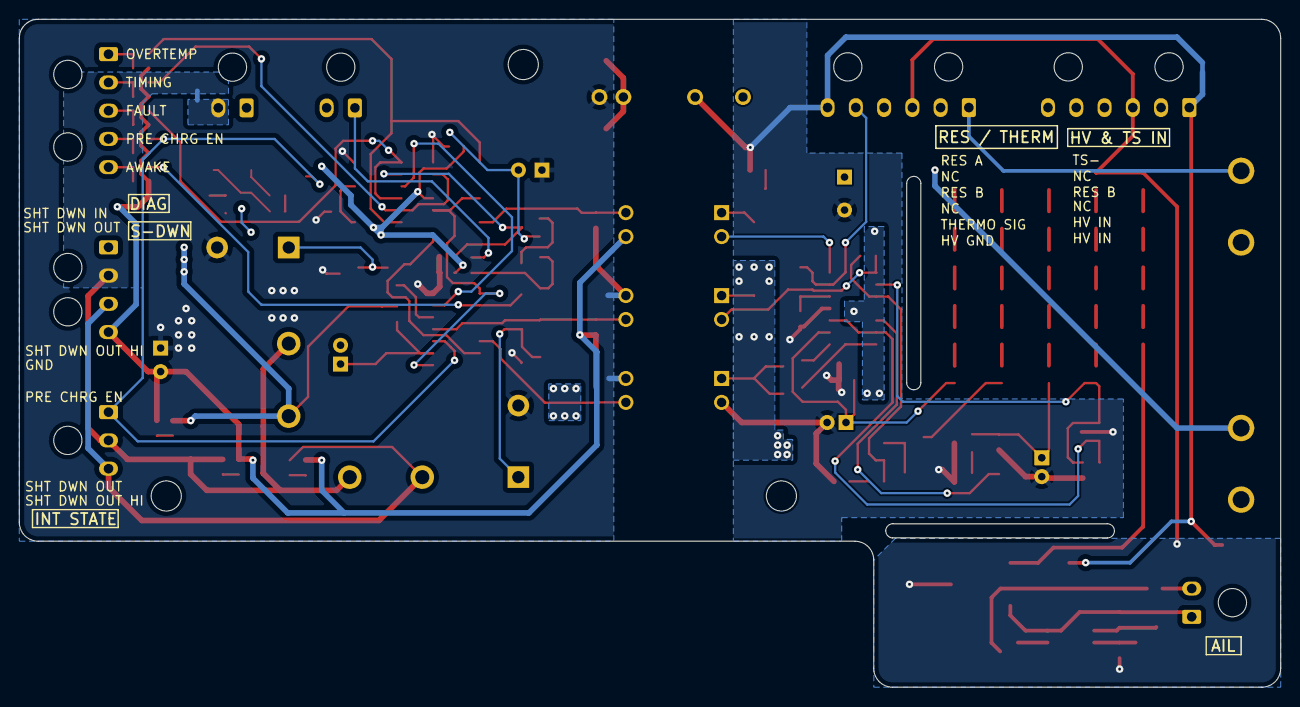
[picture p14: board precharge.kicad_pcb from below]

Board: 2 copper layers, 133.9 x 70.9 mm, 133 parts (2 on the bottom side), 94 nets.
