sufst/precharge/(commit log)

2021-08-29 Added Kicad project
    [precharge.kicad_pcb, precharge.sch]
2021-08-29 Added test symbol to schematic
    [precharge.sch]
2021-08-29 Added charge envelope sheet
    [charge-envelope.sch]
2021-10-29 Made very rough outline of the precharge/discharge circuit. Probably wrong...
    [charge-envelope.kicad_sch, precharge.kicad_sch]
2021-10-29 Deleted unused files
    I think the new version of Kicad is using different file extensions,
    so some of the old files are unused.
    [charge-envelope.sch, precharge.sch]
2021-11-09 The precharge needs to be inside the accumulator housing
    [precharge.kicad_sch]
2021-11-10 Add circuitry to make use of the inverter's analogue inputs and relay outputs
    [precharge.kicad_sch]
2021-11-20 Moved outline into a separate directory and created precharge project with just precharge circuitry
    [charge-envelope.kicad_sch, precharge.kicad_pcb, precharge.kicad_sch]
2021-11-29 Misc. changes to schematic, created PCB
    The PCB was created just to begin modelling its size.
    [precharge.kicad_pcb, precharge.kicad_sch]
2021-12-06 Modifications to outline schematic
    [precharge.kicad_sch]
2021-12-06 Deleting outline because it is no longer up to date.
    I currently have no intention of updating the outline. If someone really
    wants it, feel free to bring it back.
    [charge-envelope.kicad_sch, precharge.kicad_pcb, precharge.kicad_sch]
2021-12-06 Major changes to schematic
    - Split into HV and LV sections
    - Implemented most of the precharge logic
    [hv.kicad_sch, lv.kicad_sch, precharge.kicad_sch]
2021-12-07 Tweaks made during today's meeting
    [hv.kicad_sch, lv.kicad_sch, precharge.kicad_sch]
2022-01-06 Updated quite a bit
    - Added relay mechanical state detection
    - Selected most component values for HV side
    - Other miscellaneous changes
    [hv.kicad_sch, lv.kicad_sch, precharge.kicad_sch]
2022-01-06 Added simulation of voltage levels for charge and profile detection.
    In LTSpice, run the simulation, then click on the plot window. In the
    menu bar, select "Plot settings" and load either the
    "charge_measurement.plt" plot settings file, or the "profile.plt"
    file.
2022-01-09 Added part numbers for most components, added LEDs, tweaked LV side.
    [hv.kicad_sch, lv.kicad_sch, precharge.kicad_pcb, precharge.kicad_sch]
2022-01-19 Tweaks, nearly done
    [hv.kicad_sch, lv.kicad_sch, precharge.kicad_sch]
2022-02-02 Assigned some footprints, created footprint library
    [hv.kicad_sch, lv.kicad_sch, precharge.kicad_pcb, precharge.kicad_sch]
2022-02-04 Preliminary PCB placement
    [hv.kicad_sch, lv.kicad_sch, precharge.kicad_pcb, precharge.kicad_sch]
2022-02-04 Initial BOM
    [bom.ods]
2022-02-16 Added support for TS_ACTIVE signal, adjusted resistor divider
    [bom.ods, hv.kicad_sch, lv.kicad_sch, precharge.kicad_pcb, precharge.kicad_sch]
2022-02-16 Added footprints
2022-02-20 Restarted PCB layout
    [hv.kicad_sch, precharge.kicad_pcb, precharge.kicad_sch]
2022-04-21 Added precharge layout
    [G5Q_1.step, bom.ods, conn_molex-2-pin.stp, conn_molex-3-pin.stp, conn_molex-4-pin.stp, conn_molex-5-pin.stp, conn_molex-6-pin.stp, fuseholder.STEP]
2022-05-15 Added initial indicator light
    [hv.kicad_sch, indicator.kicad_sch, lv.kicad_sch, precharge.kicad_pcb, precharge.kicad_sch]
2022-10-03 Latest precharge updates
    [bom-2.ods, indicator.kicad_sch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]
